ethanrossauto/skryer-drone-detection/(commit log)

2026-06-22 Skryer — acoustic-cued drone-detection sentry (public)
    Passive acoustic early-warning layer with multi-node AoA triangulation, a
    ground-camera confirm step, and a React + MapLibre operator console. Includes a
    streamed, eval-gated LLM operator briefing grounded on the live contact data.
2026-06-23 Console + demo sync: ingress scenario, defense-in-depth array, acoustic/PTZ cones
    - Operator console reworked: protected asset at centre, two-ring acoustic node
    network, drones ingressing with steering behaviours + lifecycle.
    - Translucent acoustic cones (bearing ± DoA uncertainty); a track resolves to a
    triangulated fix when ≥2 cross. PTZ viewing cone follows the camera's actual
    aim; AUTO sweeps the field to maximize IDs at range.
    - Empty-load opening wave that builds up; colour scheme (bearing / range-lock /
    visual-ID).
    - LLM briefing endpoint hardening: origin gate, per-IP cap + daily budget, hard
    max_tokens; OG/Twitter social preview.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
